MatiasG19/arduino-remote-switch/(commit log)

2023-06-10 Remove HDD LED, add kill, refactor reading status
2023-06-10 Update power led status via interval
2023-06-10 Debounce power led on state
2023-06-10 Add led button, add github link
2023-07-01 fix: Fixes from testing (#2)
    * Update index.htm
    * Update server.ino
    * Fix font
    * Add favicon
    * Update favicon
    * Fix centering
    [server.ino]
2023-07-01 docs: Improve documentation (#3)
    * Improve and seperate
    * Add schematic and board pic
    * Update README.md
    * Add front panel io schematic
2023-07-02 refactor(server): Improve requests (#4)
    * Improve file request
    * Remove debug serial print
    * Rename var
    * Refactor action to switch case
    * Update comment
    * Update comment
2023-07-02 ci: Add CI (#5)
    * Add ci
    * Fix path
    * Fix path
    * Fix path
    * Fix checkout
    * Add vscode format on save
    * Format server
    * Fix path
    * Fix path
    * Add ci badge to readme
    * Fix path
    * Update ci.yml
    * Use different gitgub action for compile
    * Update ci.yml
    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
    [src.ino]
2023-11-05 fix(server): Send index.htm (#6)
    * Send index.htm
    * Update src.ino
    [src.ino]
2025-10-20 feat: host website on external webserver (#16)
    * feat(web): add fetch from url
    * feat(server): add option to use external webserver
    * feat(web): nginx dockerfile
    * ci: bump node version
    * Update BuildInstructions.md
    * Update package.json
    * fixes
    * ci: docker image release
    * feat(web): config.json
    * format
    * format
    * format
    * format
    * update instructions
    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
    [src.ino]
2026-01-24 fix(web): button actions (#23)
